algofoogle/solo_squash/wrapped_stuff/wrapper.v

`default_nettype none
`ifdef FORMAL
    `define MPRJ_IO_PADS 38    
`endif

`define USE_WB  1   // Using just wb_rst_i for my design's main reset.
// `define USE_LA  1
`define USE_IO  1
//`define USE_SHARED_OPENRAM 1
//`define USE_MEM 1
//`define USE_IRQ 1

// update this to the name of your module
module wrapped_solo_squash(
`ifdef USE_POWER_PINS
    inout vccd1,	// User area 1 1.8V supply
    inout vssd1,	// User area 1 digital ground
`endif
    input wire wb_clk_i,                            // clock, runs at system clock
 // caravel wishbone peripheral
`ifdef USE_WB
    input wire          wb_rst_i,                   // main system reset
    input wire          wbs_stb_i,                  // wishbone write strobe
    input wire          wbs_cyc_i,                  // wishbone cycle
    input wire          wbs_we_i,                   // wishbone write enable
    input wire [3:0]    wbs_sel_i,                  // wishbone write word select
    input wire [31:0]   wbs_dat_i,                  // wishbone data in
    input wire [31:0]   wbs_adr_i,                  // wishbone address
    inout wire          wbs_ack_o,                  // wishbone ack
    inout wire [31:0]   wbs_dat_o,                  // wishbone data out
`endif

// shared RAM wishbone controller
`ifdef USE_SHARED_OPENRAM
    inout wire          rambus_wb_clk_o,            // clock
    inout wire          rambus_wb_rst_o,            // reset
    inout wire          rambus_wb_stb_o,            // write strobe
    inout wire          rambus_wb_cyc_o,            // cycle
    inout wire          rambus_wb_we_o,             // write enable
    inout wire [3:0]    rambus_wb_sel_o,            // write word select
    inout wire [31:0]   rambus_wb_dat_o,            // ram data out
    inout wire [9:0]    rambus_wb_adr_o,            // 10bit address
    input wire          rambus_wb_ack_i,            // ack
    input wire [31:0]   rambus_wb_dat_i,            // ram data in
`endif

    // Logic Analyzer Signals
    // only provide first 32 bits to reduce wiring congestion
`ifdef USE_LA
    input wire [31:0]   la1_data_in,                // from CPU to your project
    inout wire [31:0]   la1_data_out,               // from your project to CPU
    input wire [31:0]   la1_oenb,                   // output enable bar (low for active)
`endif

    // IOs
`ifdef USE_IO
    input wire [`MPRJ_IO_PADS-1:0] io_in,           // in to your project
    inout wire [`MPRJ_IO_PADS-1:0] io_out,          // out from your project
    inout wire [`MPRJ_IO_PADS-1:0] io_oeb,          // out enable bar (low active)
`endif

    // IRQ
`ifdef USE_IRQ
    inout wire [2:0] user_irq,                      // interrupt from project to CPU
`endif

`ifdef USE_CLK2
    // extra user clock
    input wire user_clock2,
`endif
    
    // active input, only connect tristated outputs if this is high
    input wire active
);

    // all outputs must be tristated before being passed onto the project
    wire                        buf_wbs_ack_o;
    wire [31:0]                 buf_wbs_dat_o;
    wire [31:0]                 buf_la1_data_out;
    wire [`MPRJ_IO_PADS-1:0]    buf_io_out;
    wire [`MPRJ_IO_PADS-1:0]    buf_io_oeb;
    wire [2:0]                  buf_user_irq;
    wire                        buf_rambus_wb_clk_o;
    wire                        buf_rambus_wb_rst_o;
    wire                        buf_rambus_wb_stb_o;
    wire                        buf_rambus_wb_cyc_o;
    wire                        buf_rambus_wb_we_o;
    wire [3:0]                  buf_rambus_wb_sel_o;
    wire [31:0]                 buf_rambus_wb_dat_o;
    wire [9:0]                  buf_rambus_wb_adr_o;

    `ifdef FORMAL
    // formal can't deal with z, so set all outputs to 0 if not active
    `ifdef USE_WB
    assign wbs_ack_o    = active ? buf_wbs_ack_o    : 1'b0;
    assign wbs_dat_o    = active ? buf_wbs_dat_o    : 32'b0;
    `endif
    `ifdef USE_SHARED_OPENRAM
    assign rambus_wb_clk_o = active ? buf_rambus_wb_clk_o : 1'b0;
    assign rambus_wb_rst_o = active ? buf_rambus_wb_rst_o : 1'b0;
    assign rambus_wb_stb_o = active ? buf_rambus_wb_stb_o : 1'b0;
    assign rambus_wb_cyc_o = active ? buf_rambus_wb_cyc_o : 1'b0;
    assign rambus_wb_we_o  = active ? buf_rambus_wb_we_o  : 1'b0;
    assign rambus_wb_sel_o = active ? buf_rambus_wb_sel_o : 4'b0;
    assign rambus_wb_dat_o = active ? buf_rambus_wb_dat_o : 32'b0;
    assign rambus_wb_adr_o = active ? buf_rambus_wb_adr_o : 10'b0;
    `endif
    `ifdef USE_LA
    assign la1_data_out = active ? buf_la1_data_out  : 32'b0;
    `endif
    `ifdef USE_IO
    assign io_out       = active ? buf_io_out       : {`MPRJ_IO_PADS{1'b0}};
    assign io_oeb       = active ? buf_io_oeb       : {`MPRJ_IO_PADS{1'b0}};
    `endif
    `ifdef USE_IRQ
    assign user_irq     = active ? buf_user_irq          : 3'b0;
    `endif
    `include "properties.v"
    `else
    // tristate buffers
    
    `ifdef USE_WB
    assign wbs_ack_o    = active ? buf_wbs_ack_o    : 1'bz;
    assign wbs_dat_o    = active ? buf_wbs_dat_o    : 32'bz;
    `endif
    `ifdef USE_SHARED_OPENRAM
    assign rambus_wb_clk_o = active ? buf_rambus_wb_clk_o : 1'bz;
    assign rambus_wb_rst_o = active ? buf_rambus_wb_rst_o : 1'bz;
    assign rambus_wb_stb_o = active ? buf_rambus_wb_stb_o : 1'bz;
    assign rambus_wb_cyc_o = active ? buf_rambus_wb_cyc_o : 1'bz;
    assign rambus_wb_we_o  = active ? buf_rambus_wb_we_o  : 1'bz;
    assign rambus_wb_sel_o = active ? buf_rambus_wb_sel_o : 4'bz;
    assign rambus_wb_dat_o = active ? buf_rambus_wb_dat_o : 32'bz;
    assign rambus_wb_adr_o = active ? buf_rambus_wb_adr_o : 10'bz;
    `endif
    `ifdef USE_LA
    assign la1_data_out  = active ? buf_la1_data_out  : 32'bz;
    `endif
    `ifdef USE_IO
    assign io_out       = active ? buf_io_out       : {`MPRJ_IO_PADS{1'bz}};
    assign io_oeb       = active ? buf_io_oeb       : {`MPRJ_IO_PADS{1'bz}};
    `endif
    `ifdef USE_IRQ
    assign user_irq     = active ? buf_user_irq          : 3'bz;
    `endif
    `endif

    // Our design below asserts output enables 20:13 when active.
    // For output enables not otherwise controlled by our design,
    // set them permanently enabled (0 is output, 1 is high-impedance):
    assign buf_io_oeb[`MPRJ_IO_PADS-1:21]   = {(`MPRJ_IO_PADS-21){1'b0}};
    assign buf_io_oeb[12:0]                 = {13{1'b0}};

    // Feed 'active' line back out thru IO[20] as our debug_gpio_ready,
    // instead of via LA1, so we can exclude LA1 from our routing:
    assign buf_io_out[20] = active;

    // Instantiate your module here, 
    // connecting what you need of the above signals. 
    // Use the buffered outputs for your module's outputs.
    solo_squash_caravel adapter(
        .wb_clk_i           (wb_clk_i),
        .wb_rst_i           (wb_rst_i),

        // .gpio_ready         (la1_data_in[0]),   // In this wrapper, this is la_data_in[32].
        // .debug_gpio_ready   (buf_io_out[20]),
        //NOTE: gpio_ready (IO[20]) now comes via this wrapper itself, so we can exclude LA1 from our routing.

        .ext_reset_n        (io_in[ 8]),
        .pause_n            (io_in[ 9]),
        .new_game_n         (io_in[10]),
        .down_key_n         (io_in[11]),
        .up_key_n           (io_in[12]),

        .red                (buf_io_out[13]),
        .green              (buf_io_out[14]),
        .blue               (buf_io_out[15]),
        .hsync              (buf_io_out[16]),
        .vsync              (buf_io_out[17]),
        .speaker            (buf_io_out[18]),

        .debug_design_reset (buf_io_out[19]),

        .design_oeb         (buf_io_oeb[18:13]),
        .debug_oeb          (buf_io_oeb[20:19])
    );

endmodule 
`default_nettype wire
