algofoogle/solo_squash/(commit log)

2023-03-09 Starting to add Makefile and test framework
2023-03-12 Minor fix for unknown state of blue BG, and tests starting to be a little more 'real' (and capture a full frame as VCD)
    [test_solo_squash.py]
2023-03-13 Some files that will be needed for Caravel inc. firmware, Makefile, tests, UPW. Also some minor fixes.
    [solo_squash_tb.v, test_solo_squash.py, user_project_wrapper.v]
2023-03-13 Minor fix for Caravel tests accessing internal design_reset signal
    [solo_squash_tb.v]
2023-03-15 Improving tests a bit, and making sure test pins remain asserted through reset
    [test_solo_squash.py]
2023-03-16 Rearranged implementation of solo_squash_caravel so it doesn't overload our macro with too many signals. Also added 'test_frame0' to cocotb
    [test_solo_squash.py, user_project_wrapper.v]
2023-03-18 Adding more caravel_stuff: user_project_wrapper config.json and macro.cfg
    [macro.cfg]
2023-03-18 Tiny update to move our design (macro) close to the middle, alleviating cap/slew violations
    [macro.cfg]
2023-03-19 Updated user_defines.v to match our desired power-on inputs/outputs
2023-03-21 Making input mode config generic as INPUT_MODE, because of possible issues with GPIO_MODE_USER_STD_INPUT_PULLUP
    [solo_squash_caravel.c, user_defines.v]
2023-03-21 Changed caravel_stuff TB to show what mode is currently in effect for USER_CONFIG_GPIO_\*_INIT
2023-03-28 Constrain clock a little more for safety. Make Verilog TB print progress. Other minor edits
2023-04-01 Trying to support switching between RTL and GL tests
2023-06-02 Add metastability avoidance and registered RGB outputs for de0nano implementation
    [solo_squash_de0nano.v]
2023-08-14 Makefile change to support verilator executable switching for Windows builds
