algofoogle/solo_squash/(notices)

Notices in the files:
caravel_stuff/CUP-README.md:
License: Apache 2.0
